ArcaneNibble/remex-wch/(commit log)

2024-08-19 Initial pin allocation for MCU
    [remex-wch.kicad_sch]
2024-08-19 USB port; assign BOM data now
    [remex-wch.kicad_sch]
2024-08-19 Shuffle pins to get an internal I2C bus
    [remex-wch.kicad_sch]
2024-08-19 initial eth phy
    [remex-wch.kicad_sch]
2024-08-19 microsd socket
    [remex-wch.kicad_sch]
2024-08-19 clock generator
    [remex-wch.kicad_sch]
2024-08-19 ethernet magjack; straps
    [remex-wch.kicad_sch]
2024-08-19 rearrange positions
    [remex-wch.kicad_sch]
2024-08-19 add usb typec controller
    [remex-wch.kicad_sch]
2024-08-20 Add TBD LiPo circuitry
    [remex-wch.kicad_sch]
2024-08-20 py32 as io/adc expander and type-c supervisor
    [remex-wch.kicad_sch]
2024-08-20 tidy up a bit
    [remex-wch.kicad_sch]
2024-08-20 ch32v boot1
    [remex-wch.kicad_sch]
2024-08-20 some bom data filling in
    [remex-wch.kicad_sch]
2024-08-20 pile of capacitors
    [remex-wch.kicad_sch]
2024-08-20 copy/add easy footprints
    [remex-wch.kicad_sch]
2024-08-20 add magjack footprint
    [remex-wch.kicad_sch]
2024-08-20 add microsd footprint
    [remex-wch.kicad_sch]
2024-08-20 rough positioning of parts on pcb
    [remex-wch.kicad_pcb, remex-wch.kicad_sch]
2024-08-20 fix uSD courtyard
    [remex-wch.kicad_pcb]
2024-08-20 add reset button
    [remex-wch.kicad_pcb, remex-wch.kicad_sch]
2024-08-29 optimistic parts packing closer together
    [remex-wch.kicad_pcb]
2024-08-29 not-good-approx test routing
    [remex-wch.kicad_pcb]
2024-08-29 setup; tweaks
    [remex-wch.kicad_pcb]
2024-08-29 more board setup
    [remex-wch.kicad_pcb]
2024-08-29 better initial attempt at all the hard signals
    [remex-wch.kicad_pcb]
2024-08-29 work on power section
    [remex-wch.kicad_pcb]
2024-08-29 work on usb c mgmt section
    [remex-wch.kicad_pcb]
2024-08-29 work on clock chip
    [remex-wch.kicad_pcb]
2024-08-29 everything connected
    [remex-wch.kicad_pcb]
2024-08-29 clean up fab layers
    [remex-wch.kicad_pcb, remex-wch.kicad_sch]
2024-08-29 correct 10pf crystal
    [remex-wch.kicad_pcb, remex-wch.kicad_sch]
2024-08-29 hopefully fix nettie
    [remex-wch.kicad_pcb, remex-wch.kicad_sch]
2024-08-29 fix some part values
    [remex-wch.kicad_pcb, remex-wch.kicad_sch]
2024-08-29 silk, debug, misc
    [remex-wch.kicad_pcb]
2024-08-29 silk art
    [remex-wch.kicad_pcb]
2024-08-29 simple trace nudging
    [remex-wch.kicad_pcb]
2024-08-29 add resest label on top silk
    [remex-wch.kicad_pcb]
2024-08-29 misc poke
    [remex-wch.kicad_pcb]
2024-08-29 dim notes
    [remex-wch.kicad_pcb]
2024-09-06 small tweaks
    [remex-wch.kicad_pcb]
2024-09-06 more tweaks; prepare for adding accel
    [remex-wch.kicad_pcb]
2024-09-06 add bonus accel
    [remex-wch.kicad_pcb, remex-wch.kicad_sch]
2024-09-06 more tweaks
    [remex-wch.kicad_pcb]
